linglingltd/wifi-remote/esp8266_remote/credentials.h

#define OTA_PWD "CHOSE_OTA_PWD"
#define NAME "WiFiRemote"

// Wifi Credentials
#define SSID "YOUR_WIFI_SSID"
#define PWD "YOUR_WIFI_PWD"

// MQTT server
#define MQTT_SERVER_IP "YOUR_MQTT_BROKER_IP"
#define MQTT_PORT 1883
