linglingltd/wifi-remote/(commit log)

2023-01-23 Initial commit of current working firmware.
2023-01-24 Added readme containing current blog entry.
